SailorScott/BowspritSpinner/(commit log)

2026-02-15 Initial commit: BowspritSpinner stepper motor controller
    Arduino Nano sketch for slow-rotation bowsprit refinishing with
    speed control buttons, 10-second RPM serial reporting, and LED indicator.
2026-02-15 Add Arduino build output to .gitignore
2026-02-16 Move pulse pin from D9 to A5 (D19) and add driver wiring docs
    Puts pulse output on same side as 5V and GND for cleaner wiring.
2026-02-16 Add Nano VIN power wiring to docs
    12V power supply shared between Nano (VIN) and driver (DC+).
2026-02-18 Fix pulse width and delay handling for stepper driver
    Driver opto-isolator needs 1ms pulse width (spec says >2.5μs but
    was too short in practice). Also fixed delay overflow for large
    pulse intervals by using delay() for ms portion.
    [BowspritSpinner.ino]
